windgassen/StemStarII/README.md

# StemStarII
These are the files for the STEMStar II circuit board
