windgassen/StemStarII/Parts List/StemStarII_Parts List_REV_-.ods

Sheet: Parts List
FIND NO. | QTY | MFR PART NO. | MFR | DIST PART NO. | DIST | DESCRIPTION | REF DESIGNATOR | Price Ea QTY 100 Kits | Price Ext 1 Badge | Buy | Done
1 | 5 | CRCW1206750RFKEA | Vishay | 61M5590 | Newark | RESISTOR, CHIP, 750 OHMS, 250MW, 1206 | R1,R3,R5,R7,R9 | $0.012 | $0.060 | 625 | x
2 | 5 | CRCW1206100KFKEA | Vishay | 61M5538 | Newark | RESISTOR, CHIP, 100K OHMS, 250MW, 1206 | R2, R4, R6, R8, R10 | $0.026 | $0.130 | 625 | x
3 | 5 | MCSH31B105K160CT | Multicomp | 23T7598 | Newark | CAPACITOR, CHIP, 1UF, 16V, 10%, 1206 | C1 – C5 | $0.048 | $0.240 | 625 | x
4 | 5 | KM-23SRD | Kingbright | 25M9955 | Newark | LED, RED, SOT-23 | D1 – D5 | $0.109 | $0.545 | 625 | x
5 | 5 | 2N7002 | On Semi | 04M7288 | Newark | TRANSISTOR, MOSFET, N-CH, 60V, 115MA | Q1 – Q5 | $0.058 | $0.290 | 625 | x
6 | 1 | JS202011SCQN | C&K COMPONENTS | 95W3256 | Newark | SWITCH, SLIDE, DPDT, 100MA | S1 | $0.360 | $0.360 | 125 | x
7 | 1 | 3024-2 | Keystone | 36-3024-2-ND | Digikey | BATTERY RETAINER COIN 20MM 2CELL SMD | BT1 | $0.550 | $0.550 | 125
8 | 2 | CR2032 | Panasonic | 13C1019 | Amazon | BATTERY, LITHIUM MANGANESE, 20MM | BATTERY 1 – 2 | $0.300 | $0.600 | 250
9 | 1 | StemStarII PWB | PCBCart.com |  | PCBCart.com | PWB, STEM STAR II | PWB1 | $2.630 | $2.630 | 125 | x
10 |  |  |  |  |  |  |  |  | $0.000
 |  |  |  |  |  |  | TOTAL |  | $5.405
Revision Info
A | Initial Release
 |  |  |  |  |  | Buid | 100
 |  |  |  |  |  | Attrition | 125.00%

Sheet: Purchases
PCBCart.com | 263.34
Newark | 203.69
Amazon | 147.27
Digikey | 90.24
TOTAL | 704.54
