windgassen/StemStarII/KiCAD Schematic & PWB Files/Blink_Badge.pdf

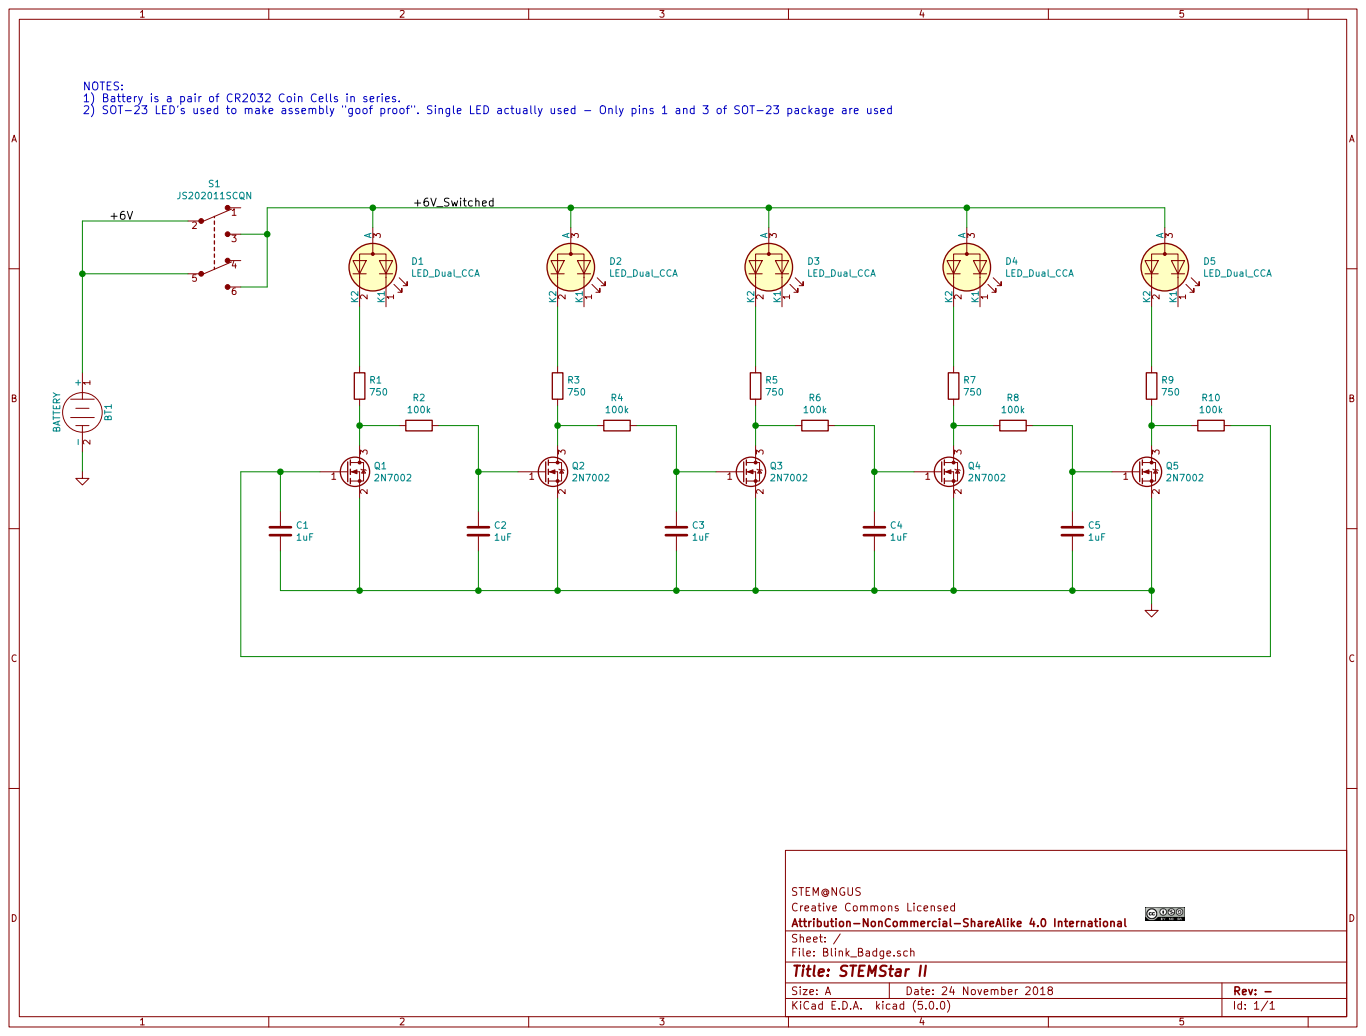
[picture p1: page 1]

NOTES:
1) Battery is a pair of CR2032 Coin Cells in series.
2) SOT-23 LED's used to make assembly "goof proof". Single LED actually used - Only pins 1 and 3 of SOT-23 package are used

File: Blink_Badge.sch Sheet: / Attribution-NonCommercial-ShareAlike 4.0 International Creative Commons Licensed STEM@NGUS

Id: 1/1 Title: STEMStar II
