windgassen/StemStarII/LTSpice/5 LED Chaser.asc

C1: cap; {C}
C2: cap; {C}
C3: cap; {C}
C4: cap; {C}
C5: cap; {C}
D1: LED; RED_LED
D2: LED; RED_LED
D3: LED; RED_LED
D4: LED; RED_LED
D5: LED; RED_LED
Q1: nmos; 2N7002
Q2: nmos; 2N7002
Q3: nmos; 2N7002
Q4: nmos; 2N7002
Q5: nmos; 2N7002
R1: res; {Rload}
R2: res; {R}
R3: res; {Rload}
R4: res; {R}
R5: res; {Rload}
R6: res; {R}
R7: res; {Rload}
R8: res; {R}
R9: res; {Rload}
R10: res; {R}
V1: voltage; 6
Named nets: 0, +6V
* RED LED Liteon LTL1CHKEKNN
* created November 23, 2010 copyright Cordell Audio
.model RED_LED D(Is=1.0e-12 N=3.0 Rs=9.0 Eg=2.17 Tnom=27deg)
*
.tran 10
3 (or any odd number) FET LED Chaser Circuit
.param C 1uF
.param R 100k
.param Rload 750
