windgassen/StemStarII/KiCAD Schematic & PWB Files/Blink_Badge.kicad_pcb

## KiCad design KiCAD Schematic & PWB Files/Blink_Badge.kicad_pcb (2019-02-19)

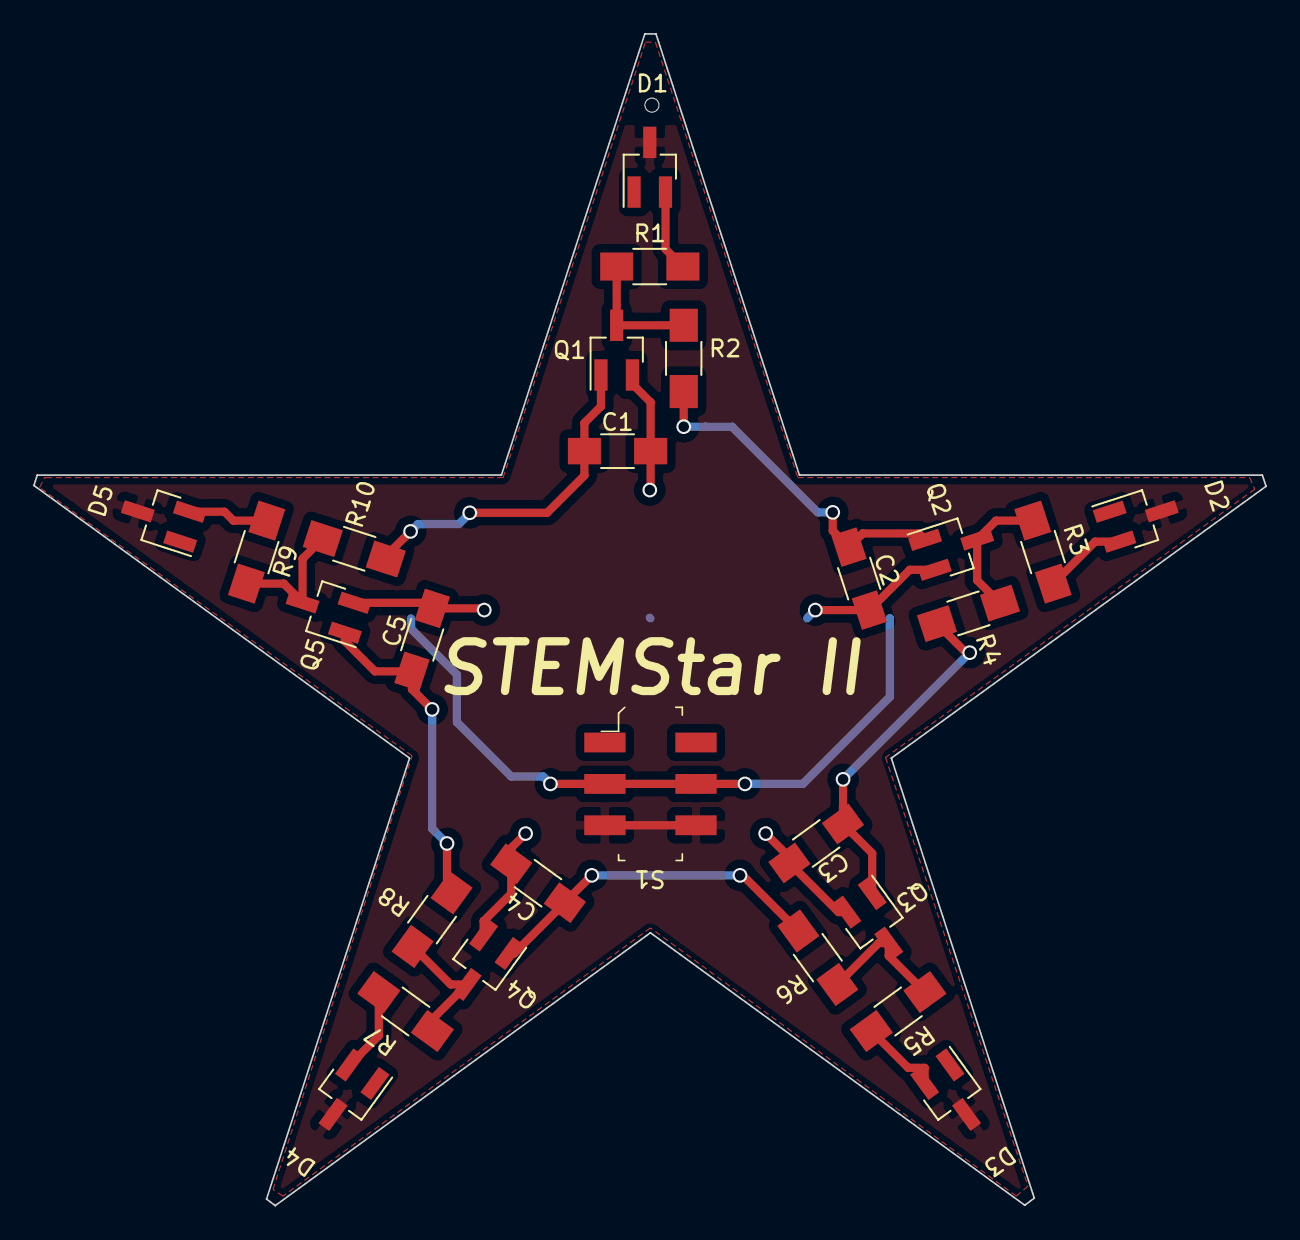
[picture p2: board Blink_Badge.kicad_pcb from above]

Board: 2 copper layers, 74.4 x 70.8 mm, 28 parts (1 on the bottom side), 18 nets.

Parts:
BT1: BATTERY; Keystone_3024-2_2x20mm-CoinCell
C1, C2, C3, C4, C5: 1uF; C_1206_HandSoldering
D1, D2, D3, D4, D5: LED_Dual_CCA; SOT-23_Handsoldering
MH1: StemStar_Mounting_Pads
Q1, Q2, Q3, Q4, Q5: 2N7002; SOT-23_Handsoldering
R1, R3, R5, R7, R9: 750; R_1206_HandSoldering
R2, R4, R6, R8, R10: 100k; R_1206_HandSoldering
S1: JS202011SCQN; Switch_Slide_JS202011SCQN

Connections:
/+6V: BT1.1, S1.2, S1.5
/+6V_Switched: D1.3, D2.3, D3.3, D4.3, D5.3, S1.3, S1.6
GND: BT1.2, C1.2, C2.2, C3.2, C4.2, C5.2, Q1.2, Q2.2, Q3.2, Q4.2, Q5.2
unnamed: C1.1, Q1.1, R10.1
unnamed: C2.1, Q2.1, R2.1
unnamed: C3.1, Q3.1, R4.1
unnamed: C4.1, Q4.1, R6.1
unnamed: C5.1, Q5.1, R8.1
unnamed: D1.2, R1.1
unnamed: D2.2, R3.1
unnamed: D3.2, R5.1
unnamed: D4.2, R7.1
unnamed: D5.2, R9.1
unnamed: Q1.3, R1.2, R2.2
unnamed: Q2.3, R3.2, R4.2
unnamed: Q3.3, R5.2, R6.2
unnamed: Q4.3, R7.2, R8.2
unnamed: Q5.3, R9.2, R10.2
